ThatCrazyDcGuy/AE-5900_Remote_v1/AE-5900_MIC_PINOUT.jpg

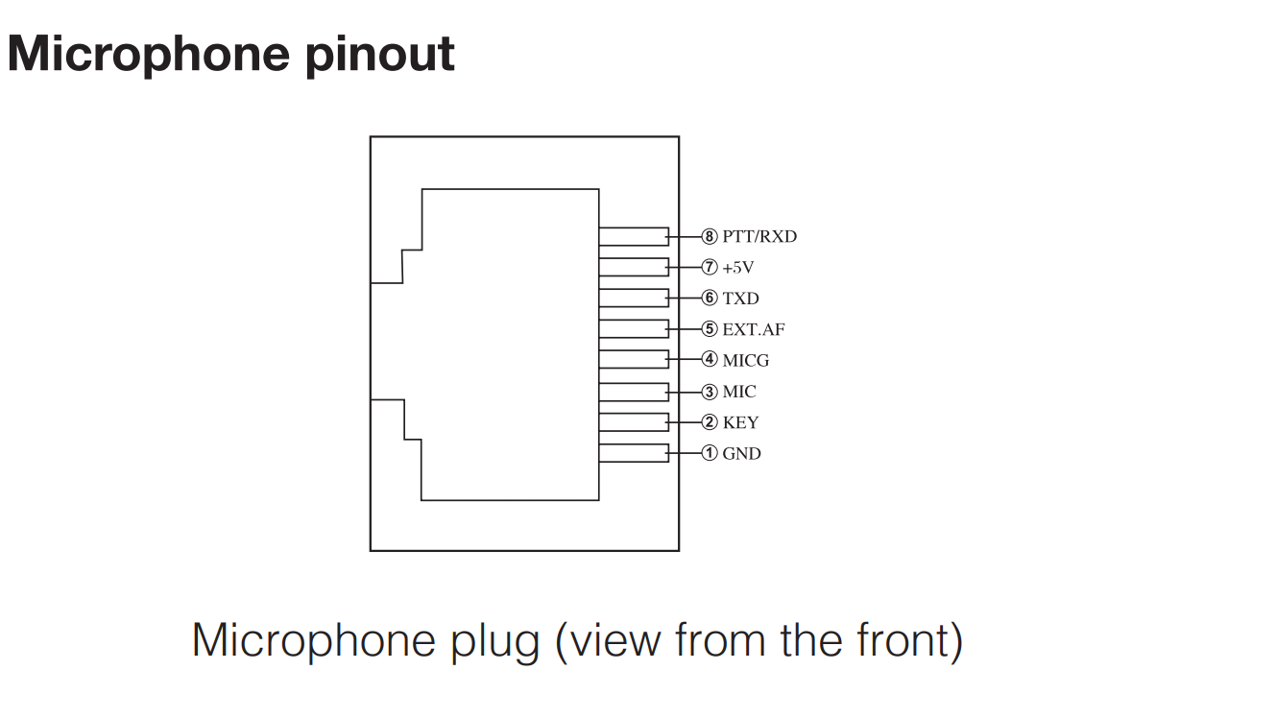
AE-5900_MIC_PINOUT.jpg
