ThatCrazyDcGuy/AE-5900_Remote_v1/shematics/32u4tomicplug.png

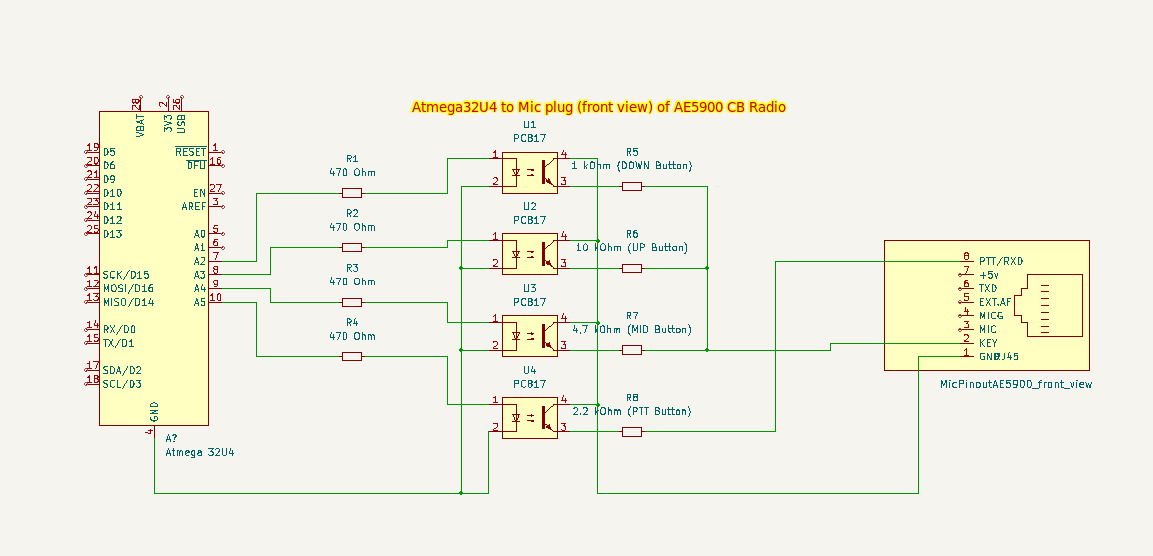
shematics/32u4tomicplug.png
