ThatCrazyDcGuy/AE-5900_Remote_v1/shematics/soundcardOUT2micplug.png

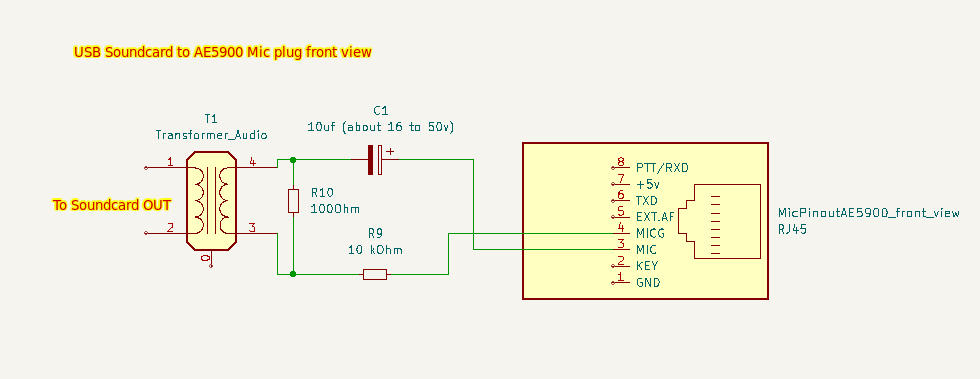
shematics/soundcardOUT2micplug.png
